NOVA-XO/ABU_Robocon_2026/(list of files, cad)

Other CAD files:
hardware/pcb_3d.obj
