NOVA-XO/ABU_Robocon_2026/Robot1_Code/Core/Src/main.c

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
/* Includes ------------------------------------------------------------------*/
#include "main.h"

/* USER CODE BEGIN Includes */
#include "general.h"
#include "test.h"
#include <stdio.h>
/* USER CODE END Includes */

/* USER CODE BEGIN PD */
/* ---- Robot1 2 PCB сонголт: build хийхээсээ ӨМНӨ 1/2 болгож сольж flash --- */
#define R1_PCB 2 // 1 = 1-р PCB (жолоо/актуатор),  2 = 2-р PCB
/* USER CODE END PD */

ADC_HandleTypeDef hadc1;

I2C_HandleTypeDef hi2c2;

TIM_HandleTypeDef htim1;
TIM_HandleTypeDef htim3;
TIM_HandleTypeDef htim4;
TIM_HandleTypeDef htim7;
TIM_HandleTypeDef htim13;

UART_HandleTypeDef huart4;
UART_HandleTypeDef huart3;
DMA_HandleTypeDef hdma_uart4_tx;

void SystemClock_Config(void);
static void MX_GPIO_Init(void);
static void MX_DMA_Init(void);
static void MX_I2C2_Init(void);
static void MX_TIM1_Init(void);
static void MX_UART4_Init(void);
static void MX_USART3_UART_Init(void);
static void MX_TIM3_Init(void);
static void MX_TIM4_Init(void);
static void MX_TIM7_Init(void);
static void MX_TIM13_Init(void);
static void MX_ADC1_Init(void);
/* USER CODE BEGIN PFP */

int control_data[5][4] = {0};

void send_DMA(uint8_t command) {
  HAL_UART_Transmit(&huart4, &command, 1, HAL_MAX_DELAY);
}
uint8_t information[23]; // шинэ урт
uint8_t rx_idx = 0;
uint8_t data;

/* ---- 2 PCB хоорондын UART4 холбоо: [0x0A][pwm1][pwm2][pwm3][0x0D]
 * ------------ PCB1 → r1_link_send3(p1,p2,p3),  PCB2 ← RX callback
 * (r1_link_p1/2/3). ⚠ PCB1 UART4_TX(PA0) → PCB2 UART4_RX(PA1) + GND утсаар
 * холбоно.               */
volatile uint8_t r1_link_p1 = 100; // PCB2: ирсэн pwm1 (100 = нейтрал/зогсох)
volatile uint8_t r1_link_p2 = 100; // PCB2: ирсэн pwm2
volatile uint8_t r1_link_p3 = 100; // PCB2: ирсэн pwm3
volatile uint8_t r1_link_new = 0;  // 1 = шинэ багц ирлээ (уншаад 0 болгоно)
static uint8_t link_byte = 0;      // UART4 RX буфер (1 байт)
static uint8_t link_state = 0;     // 0=START 1..3=pwm 4=END
static uint8_t link_tmp[3] = {0};  // задарч буй pwm-ууд

/* PCB1 → PCB2: [0x0A][p1][p2][p3][0x0D] (UART4 TX, blocking богино) */
void r1_link_send3(uint8_t p1, uint8_t p2, uint8_t p3) {
  uint8_t pkt[5] = {0x0A, p1, p2, p3, 0x0D};
  HAL_UART_Transmit(&huart4, pkt, 5, 5);
}

/* -----------------------------------------------------------------------------
 *  HAL_UART_RxCpltCallback — ESP32-оос ирсэн PS5 багцыг задлах (huart3, 1
 * байт/удаа)
 *
 *  Багц: 23 байт,  [0]=0xAA (START) ... [22]=0x0A (END),  [21]=холболтын флаг.
 *  START байт хүлээж, 23 байт бүрдэхэд задалж control_data[5][4]-д хийнэ.
 *
 *  ─ Джойстик (information[1..4] − 100 → control_data[0][0..3], утга −100..100)
 * ─ control_data[0][0] = Зүүн стик X       control_data[0][2] = Баруун стик X
 *      control_data[0][1] = Зүүн стик Y       control_data[0][3] = Баруун стик
 * Y
 *
 *  ─ Товч (information[5..20] → control_data[1..4][0..3], утга 0/1) ─
 *      control_data[1][0]=Cross    [1][1]=Square   [1][2]=Triangle
 * [1][3]=Circle control_data[2][0]=D-Down   [2][1]=D-Right  [2][2]=D-Up
 * [2][3]=D-Left control_data[3][0]=L1       [3][1]=R1       [3][2]=L2 [3][3]=R2
 *      control_data[4][0]=Share    [4][1]=Options  [4][2]=L3       [4][3]=R3
 *
 *  Холбогдоогүй (флаг = 0) бол бүх утгыг 0 болгож цэвэрлэнэ.
 * -----------------------------------------------------------------------------
 */
void HAL_UART_RxCpltCallback(UART_HandleTypeDef *huart) {
  if (huart == &huart3) {
    if (rx_idx == 0 && data != 0xAA) {
      HAL_UART_Receive_IT(&huart3, &data, 1);
      return;
    }

    information[rx_idx++] = data;

    if (rx_idx == 23 && information[22] == 0x0A) {
      uint8_t isConnected = information[21];

      if (isConnected == 1) {
        // --- Джойстик: information[1..4] → control_data[0][0..3], төв 100-г
        // хасаж -100..100 ---
        //   [0][0]=LStickX  [0][1]=LStickY  [0][2]=RStickX  [0][3]=RStickY
        for (int i = 0; i < 4; i++) {
          control_data[0][i] = information[1 + i] - 100;
        }

        // --- Товч: information[5..20] → control_data[1..4][0..3] (0/1) ---
        //   мөр 1 = Cross/Square/Triangle/Circle
        //   мөр 2 = D-pad Down/Right/Up/Left
        //   мөр 3 = L1/R1/L2/R2
        //   мөр 4 = Share/Options/L3/R3
        for (int i = 0; i < 16; i++) {
          control_data[1 + (i / 4)][i % 4] = information[5 + i];
        }

      } else {
        // --- Холбогдоогүй: бүх джойстик/товчийг тэглэх ---
        for (int i = 0; i < 5; i++) {
          for (int j = 0; j < 4; j++) {
            control_data[i][j] = 0;
          }
        }
      }

      rx_idx = 0;
    } else if (rx_idx >= 23) {
      rx_idx = 0; // invalid
    }

    HAL_UART_Receive_IT(&huart3, &data, 1);
  } else if (huart == &huart4) {
    /* PCB2: [0x0A][p1][p2][p3][0x0D] багцыг задлана */
    switch (link_state) {
    case 0:
      if (link_byte == 0x0A)
        link_state = 1;
      break; // START
    case 1:
      link_tmp[0] = link_byte;
      link_state = 2;
      break; // pwm1
    case 2:
      link_tmp[1] = link_byte;
      link_state = 3;
      break; // pwm2
    case 3:
      link_tmp[2] = link_byte;
      link_state = 4;
      break; // pwm3
    default: // END
      if (link_byte == 0x0D) {
        r1_link_p1 = link_tmp[0];
        r1_link_p2 = link_tmp[1];
        r1_link_p3 = link_tmp[2];
        r1_link_new = 1;
      }
      link_state = 0;
      break;
    }
    HAL_UART_Receive_IT(&huart4, &link_byte, 1);
  }
}

/* USER CODE END PFP */

/* USER CODE BEGIN 0 */

extern int timer;
extern int counter[4];

uint8_t usb_received_value = 0;
uint8_t usb_new_data_flag = 0;

/* USER CODE END 0 */

/**
 * @brief  The application entry point.
 * @retval int
 */
int main(void) {

  /* MCU Configuration--------------------------------------------------------*/

  /* Reset of all peripherals, Initializes the Flash interface and the Systick.
   */
  HAL_Init();

  /* Configure the system clock */
  SystemClock_Config();

  /* Initialize all configured peripherals */
  MX_GPIO_Init();
  MX_DMA_Init();
  MX_I2C2_Init();
  MX_TIM1_Init();
  MX_UART4_Init();
  MX_USART3_UART_Init();
  MX_TIM3_Init();
  MX_TIM4_Init();
  MX_TIM7_Init();
  MX_TIM13_Init();
  MX_ADC1_Init();
  /* USER CODE BEGIN 2 */
  generalInit();

#if R1_PCB == 2
  /* PCB2: PCB1-ээс UART4 команд хүлээж авахаар RX interrupt-ыг зэвсэглэнэ */
  HAL_UART_Receive_IT(&huart4, &link_byte, 1);
#endif

  /* ГАР УДИРДЛАГАТАЙ РОБОТ (manual)
   *   Autonomous хэсэг (LPMS gyro, sequence, red/blue) хасагдсан.
   *   PS5 джойстикоор differential (tank) жолоодоно; серво/соленоид/brush зэрэг
   *   товчны удирдлагыг while(1) дотор нэмнэ.
   */
  /* USER CODE END 2 */

  /* Infinite loop */
  /* USER CODE BEGIN WHILE */
  while (1) {
    /* R1_PCB (PD хэсэгт) сонголтоор тухайн PCB-ийн удирдлага ажиллана */
#if R1_PCB == 1
    robot1_pcb1(); // 1-р PCB: жолоо + соленоид + мотор 5/6
#else
    robot1_pcb2(); // 2-р PCB
#endif
  }
  /* USER CODE END WHILE */

}

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
