NOVA-XO/ABU_Robocon_2026/Robot2_PCB2_Code/Robot2_PCB2_Code.ioc

Mcu.UserName=STM32F407VETx
PA0-WKUP.GPIO_Label=TX
PA0-WKUP.Signal=UART4_TX
PA1.GPIO_Label=RX
PA1.Signal=UART4_RX
PA10.GPIO_Label=Brush2
PA10.Signal=S_TIM1_CH3
PA11.Signal=USB_OTG_FS_DM
PA12.Signal=USB_OTG_FS_DP
PA13.Signal=SYS_JTMS-SWDIO
PA14.Signal=SYS_JTCK-SWCLK
PA15.GPIO_Label=OP2
PA15.Signal=GPIO_Output
PA2.Signal=USART2_TX
PA3.Signal=USART2_RX
PA4.GPIO_Label=Sen8
PA4.Signal=GPIO_Input
PA6.GPIO_Label=SERVO
PA6.Signal=S_TIM13_CH1
PA8.GPIO_Label=Brush1
PA8.Signal=S_TIM1_CH1
PA9.GPIO_Label=OP4
PA9.Signal=GPIO_Output
PB1.GPIO_Label=M2Pwm
PB1.Signal=S_TIM3_CH4
PB10.GPIO_Label=SCL
PB10.Signal=I2C2_SCL
PB11.GPIO_Label=SDA
PB11.Signal=I2C2_SDA
PB3.GPIO_Label=M5InB
PB3.Signal=GPIO_Output
PB4.GPIO_Label=En1_In
PB4.Signal=GPIO_Input
PB5.GPIO_Label=M6InA
PB5.Signal=GPIO_Output
PB6.GPIO_Label=En2_Ext
PB6.Signal=GPXTI6
PB7.GPIO_Label=M6InB
PB7.Signal=GPIO_Output
PB8.GPIO_Label=En1_Ext
PB8.Signal=GPXTI8
PB9.GPIO_Label=M1Pwm
PB9.Signal=S_TIM4_CH4
PC0.GPIO_Label=Sen6
PC0.Signal=GPIO_Input
PC1.GPIO_Label=M3InB
PC1.Signal=GPIO_Output
PC11.GPIO_Label=OP1
PC11.Signal=GPIO_Output
PC12.GPIO_Label=En4_In
PC12.Signal=GPIO_Input
PC13-ANTI_TAMP.GPIO_Label=M2InB
PC13-ANTI_TAMP.Signal=GPIO_Output
PC14-OSC32_IN.GPIO_Label=Sen5
PC14-OSC32_IN.Signal=GPIO_Input
PC15-OSC32_OUT.GPIO_Label=M3InA
PC15-OSC32_OUT.Signal=GPIO_Output
PC2.GPIO_Label=Sen7
PC2.Signal=GPIO_Input
PC3.GPIO_Label=photoRes
PC3.Signal=SharedAnalog_PC3
PC6.GPIO_Label=M6Pwm
PC6.Signal=S_TIM3_CH1
PC7.GPIO_Label=M5Pwm
PC7.Signal=S_TIM3_CH2
PC8.GPIO_Label=OP6
PC8.Signal=GPIO_Output
PC9.GPIO_Label=OP5
PC9.Signal=GPIO_Output
PD1.GPIO_Label=En3_In
PD1.Signal=GPIO_Input
PD10.GPIO_Label=OP3
PD10.Signal=GPIO_Output
PD11.GPIO_Label=BnoReset
PD11.Signal=GPIO_Output
PD12.GPIO_Label=M3Pwm
PD12.Signal=S_TIM4_CH1
PD13.GPIO_Label=OP8
PD13.Signal=GPIO_Output
PD14.GPIO_Label=M4Pwm
PD14.Signal=S_TIM4_CH3
PD15.GPIO_Label=OP7
PD15.Signal=GPIO_Output
PD2.GPIO_Label=M4InA
PD2.Signal=GPIO_Output
PD3.GPIO_Label=En2_In
PD3.Signal=GPIO_Input
PD4.GPIO_Label=M4InB
PD4.Signal=GPIO_Output
PD5.GPIO_Label=En4_Ext
PD5.Signal=GPXTI5
PD6.GPIO_Label=M5InA
PD6.Signal=GPIO_Output
PD7.GPIO_Label=En3_Ext
PD7.Signal=GPXTI7
PD8.Signal=USART3_TX
PD9.Signal=USART3_RX
PE0.GPIO_Label=Sen1
PE0.Signal=GPIO_Input
PE1.GPIO_Label=M1InA
PE1.Signal=GPIO_Output
PE11.Signal=S_TIM1_CH2
PE14.Signal=S_TIM1_CH4
PE2.GPIO_Label=Sen2
PE2.Signal=GPIO_Input
PE3.GPIO_Label=M1InB
PE3.Signal=GPIO_Output
PE4.GPIO_Label=Sen3
PE4.Signal=GPIO_Input
PE5.GPIO_Label=M2InA
PE5.Signal=GPIO_Output
PE6.GPIO_Label=Sen4
PE6.Signal=GPIO_Input
PE8.GPIO_Label=Buzzer
PE8.Signal=GPIO_Output
PH0-OSC_IN.Signal=RCC_OSC_IN
PH1-OSC_OUT.Signal=RCC_OSC_OUT
