NOVA-XO/ABU_Robocon_2026/Robot2_Code/Core/Inc/red.h

/* =============================================================================
 *  red.h — Улаан (red) талын автомат зэвсгийн дараалал (weapon_red)
 *
 *  weapon_blue-ийн ТОЛИН ТУСГАЛ (align БАРУУН тийш, эцсийн эргэлт −180°).
 *
 *  Төсөл : STM32F407 Robot Firmware
 *  Огноо : Aug 22, 2026
 *  Автор : nova
 * =============================================================================
 */

#ifndef INC_RED_H_
#define INC_RED_H_

#include "general.h" // main.h, ssd1306.h, default.h, lpms.h-г дамжуулж авчирна

uint8_t weapon_red(void);       // улаан талбарын дараалал — дуусвал 1
void    weapon_red_reset(void); // эхнээс нь дахин ажиллуулах

#endif /* INC_RED_H_ */
