NOVA-XO/ABU_Robocon_2026/Robot2_PCB2_Code/Core/Inc/tactic.h

/* =============================================================================
 *  tactic.h — "Scroll & Zone Tracker" тактикийн сүлжээ (ABU Robocon 2026)
 *
 *  3 багана x 4 мөр сүлжээ. Бокс бүр  "---" → "FAK" → "R1S" → "R2S"  циклээр
 *  солигдоно. Курсор ба сонголтыг PS5 джойстикоор (PCB1-ээс USART2-оор ирнэ)
 *  удирдана. Төлөв өөрчлөгдөх бүрд төв систем рүү UART4-өөр GRID мөр илгээнэ.
 *
 *  Хамаарал: ssd1306 (OLED, hi2c2), default.c/send_uart (huart4), control_data.
 *
 *  Төсөл : STM32F407 Robot2 PCB2 Firmware
 *  Автор : nova
 * =============================================================================
 */

#ifndef INC_TACTIC_H_
#define INC_TACTIC_H_

#include "main.h"

/* -----------------------------------------------------------------------------
 *  Tactic_Task — тактикийн сүлжээний НЭГ давталт (non-blocking).
 *
 *  selectMode()-оос  while(true){ Tactic_Task(); }  хэлбэрээр дуудна. Дотроо
 *  ямар ч блоклодог HAL_Delay ашиглахгүй — бүх цаг хугацаа HAL_GetTick дээр.
 *  Эхний дуудалтад өөрийгөө init хийж, анхны (бүх хоосон) төлвийг илгээнэ.
 * -----------------------------------------------------------------------------
 */
void Tactic_Task(void);

#endif /* INC_TACTIC_H_ */
