NOVA-XO/ABU_Robocon_2026/(commit log)

2026-07-04 Initial commit: ABU Robocon 2026 STM32 robot firmware
    - Mecanum drive, rack PID (encoder, TIM7 ISR-held)
    - LPMS-BE2 gyro turning/straight, anchor heading
    - Non-blocking sequence blocks (up_20/down_20/up_40/down_40), red/blue sides
    - PS5 controller via ESP32 UART bridge
    - SSD1306 OLED, PCA9685, solenoids, servos
2026-07-08 WIP: rack удирдлагын шинэчлэл + limit switch homing (тохиргоо дуусаагүй)
    Rack унах / савлах асуудлыг шийдэх зорилгоор удирдлагын гогцоог дахин зохиов:
    - rack_step: тасралтгүй PID + таталцлын feedforward + шүүсэн (low-pass)
    derivative damping + integral gravity compensation. Роботын жин
    нэмэгдэхэд барих хүчээ автоматаар тохируулна.
    - Rack_SetHome: доод limit switch хүртэл буулгаж encoder-ийг тэглэнэ
    (debounce, timeout; switch олдоогүй бол тэглэлгүй аюулгүй зогс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
2026-07-08 chore: төслийн нэрийг Robot2_Code болгов
    - .project : <name>Code</name> → Robot2_Code
    - CMakeLists.txt : CMAKE_PROJECT_NAME → Robot2_Code
    - Code.ioc → Robot2_Code.ioc (ProjectName / ProjectFileName шинэчлэв)
    - Code Debug.launch → Robot2_Code Debug.launch
    (elf нэр, PROJECT_ATTR, MAPPED_RESOURCE_PATHS шинэчлэв)
    - .cproject : хуучнаас үлдсэн "kle_code" нэрийг Robot2_Code болгов
    (buildPath ба project name хоёуланг)
    - .launch дотор өөр компьютерийн зам (Chinbayar\workspace_2.1.1) үлдсэнийг зассан
    ТЭМДЭГЛЭЛ: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
2026-07-08 refactor: repo-г monorepo болгож өөрчлөв (Robot1_Code + Robot2_Code)
    Хоёр роботын төслийг нэг репод дэд фолдер болгон нэгтгэв:
    - Robot2_Code — автомат робот (сүүлийн код, өмнөх root агуулга)
    - Robot1_Code — гар удирдлагатай робот (general.c/.h, main.c-г
    Robot2-ийн сүүлийн хувилбартай тэнцүүлж ижил суурьнаас эхлүүлэв)
    - Дээд түвшний .gitignore нэмэв (.metadata/ үл хэрэгсэнэ)
2026-07-08 refactor(Robot1): гар роботоос autonomous модулиудыг хасав
    Гар удирдлагатай роботод шаардлагагүй хэсгүүдийг устгав:
    - Устгасан файл: lpms, bno055, sequence, red, blue (.c/.h)
    - general.h/.c: gyro функц (Drive_Straight, Gyro_TurnAngle) болон
    lpms.h include-ийг хасав. mecanum (runner) + rack PID үлдээв.
    - main.c: autonomous include болон оношилгооны блокийг цэвэрлэж,
    while(1)-д runner() (гар mecanum жолоо) тавьв.
    - CMakeLists.txt: target_sources-оос устгасан файлуудыг хасав.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
2026-07-08 chore: multi-root workspace нэмэв (Robot1 + Robot2 зэрэг нээх)
2026-07-08 docs: root README, hardware/ фолдер, нийтлэг ESP32 гүүр; Robot1 README
    - Root README.md — monorepo тойм (2 робот, нэг ижил PCB, ESP32 гүүр)
    - ps5_esp32_bridge.ino-г хоёр фолдероос гаргаж, root-ийн нийтлэг
    ps5_esp32_bridge/ фолдер руу зөөв (давхардал арилгав)
    - Robot1_Code/README.md — гар роботод тохируулж дахин бичив
    - Robot2_Code/README.md — автомат робот гэдгийг тэмдэглэж, ESP32 холбоос засав
    - hardware/ фолдер — PCB (EasyEDA) зураг/файл нэмэх заавартай
    - .code-workspace — clangd тох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
2026-07-08 chore: root main.c давхардлыг устгав (build-д ороогүй хуучин хуулбар)
    Жинхэнэ entry point нь Core/Src/main.c (cmake-ийн MX_Application_Src-д
    зөвхөн тэр орсон). Robot1_Code/main.c ба Robot2_Code/main.c нь хуучин
    хуулбарууд байсан.
2026-07-08 docs(hardware): PCB схемийн функциональ блокуудыг баримтжуулав
2026-07-08 feat(hardware): PCB 3D загвар нэмэв (Git LFS, 21MB)
    pcb_3d.obj (Git LFS) + pcb_3d.mtl. mtllib заагчийг цэвэр нэр рүү зассан.
    .gitattributes-д hardware/*.obj-г LFS-ээр tracking хийв.
    [pcb_3d.obj]
2026-07-08 docs(hardware): PCB layout + 6 schematic зураг нэмэв
    hardware/pcb.png (root README-д харагдана) + Sheet1..6 схемүүд;
    hardware/README.md дотор бүгдийг embed хийв.
2026-07-08 fix(Robot2): general.c-д <stdlib.h> нэмэв (abs() build алдаа)
    GCC 14 дээр -Wimplicit-function-declaration нь warning биш АЛДАА тул
    runner() доторх abs() build-ыг зогсоож байв.
    [general.c]
2026-07-08 refactor(Robot1): differential робот болгов, rack устгав, жолоо тааруулав
    Robot1 бол mecanum БИШ, энгийн differential (tank) гар робот тул:
    - runner(): mecanum inverse kinematics -> differential mixing (strafe хассан).
    V (урагш) ба W (эргэлт)-д ТУСДАА gain: SPEED_GAIN=10 (стик 100 -> 1000 PWM),
    TURN_GAIN=8 (стик 100 -> 800 PWM). Нормчлолыг PWM орон зайд ±1000 руу
    шилжүүлсэн тул явж байхад эргэлтийн хүч хадгалагдана (өмнө нь 800-д таслагдаж
    байлаа).
    - Rack-ийн БҮХ кодыг устгав (энэ роб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
2026-07-08 docs: README-г differential болгож шинэчлэв (Robot1 mecanum/rack хассан)
    - Robot1 README: mecanum -> differential (tank); rack хэсэг устгав;
    SPEED_GAIN/TURN_GAIN тэмдэглэв; актуатор үйлдлүүд хэрэгжээгүйг #2-т холбов.
    - Root README: Robot1-ийг "differential (tank) жолоодлого" болгов.
    Ref #2
2026-07-14 feat(Robot1): гар роботын актуатор удирдлага (соленоид toggle)
    Гарын гогцоонд механизмын удирдлага нэмэв (өмнө нь зөвхөн жолоодлого):
    - solenoidControl(): L1/R1/L2/R2 -> соленоид 1/5/2/4. Товч дарах бүрд
    HIGH <-> LOW сэлгэнэ (toggle). Дараад барихад давтахгүй — debounce хийсэн
    ЦЭВЭР rising-edge (btn_rising). Холболтыг SOLENOID_MAP хүснэгтээр удирдана.
    - Square -> соленоид 6 (момент), D-Up/D-Down -> мотор 6, Triangle/Cross -> мотор 5.
    - Build эвдрэл засав: main.c-д сан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
2026-07-14 feat(Robot2): rack тохируулга баталгаажуулав, PID тааруулав, preset + серво нэмэв
    RACK ТОХИРУУЛГА (тоног төхөөрөмж дээр ХЭМЖИЖ тогтоов):
    - Rack_Joystick_Test-ийг АВТОМАТ илрүүлэгч болгов: мотор<->encoder хос,
    PWM<->encoder чиглэлийн нийцэл, мотор<->limit switch харьяаллыг өөрөө хэмжинэ.
    - Хэмжилт: FRONT = M6 / counter[1] / S2 , BACK = M5 / counter[0] / S1.
    Чиглэл: +PWM -> counter ӨСНӨ (хоёуланд нь).
    - ЗАСВАР: rack_at_home() нь switch-ийг enc индексээр сонгодог байсан т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
2026-07-17 refactor(Robot1): USB CDC устгав, ADC хөлийг OP3 болгов
    CubeMX-ээс USB_DEVICE/CDC-г бүрэн хасав (USB_DEVICE/, Middlewares дахь
    USB Device Library, HAL PCD/LL_USB драйверууд). Robot1-д USB ашиглагдахгүй
    байсан тул зөвхөн build-ийг хүндрүүлж байв.
    Мөн:
    - photoRes_Pin (PC3) → OP3: ADC оролтоос соленоид 3-ын гаралт болгов.
    generalInit нь MX_ADC1_Init-ийн ДАРАА ажилладаг тул PC3-ыг
    GPIO_MODE_OUTPUT_PP болгож analog горимыг дарж бичнэ.
    - SOLENOID_MAP: R1-ийн соленоидыг 5 → 3 болгов.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
2026-07-17 feat(Robot2): 90° gyro эргэлт, Drive_Straight, weapon_blue, горим сонголт
    Gyro эргэлт (general.c):
    - Gyro_TurnAngle-ийг ажиллах болгов: init доторх HAL_Delay(25мс) хасав
    (LPMS-ийн урсгалыг иддэг), KD/KI идэвхжүүлэв (өмнө нь цэвэр P), шүүсэн
    derivative нэмэв (LPMS 90Hz vs PID 10ms → түүхий derivative чимээтэй).
    - Тааруулга хэмжилтээр: 14° алдаа дээр ~110 PWM өгч 76°-д ГАЦАЖ байсан тул
    KP 5→12, MIN_PWM 50→200 (дугуй газар зурах статик үрэлт). TOL 3→1.5
    (3.0 үед 87°-д зогсдог б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
2026-07-17 feat(Robot2_PCB2): 2 дахь PCB-ийн төсөл үүсгэв (Robot2_Code-оос цэвэр суурь)
    Robot2 нь хоёр PCB-тэй. Энэ бол 2 дахь самбарын firmware — Robot2_Code-оос
    хуулж, тухайн самбарт байхгүй тоног төхөөрөмжийн кодыг хасав.
    Төслийн нэр солив: .project, .cproject, CMakeLists.txt, .ioc (файл + доторх
    ProjectName/ProjectFileName), Debug.launch — бүгд Robot2_PCB2_Code.
    ХАССАН (энэ самбарт байхгүй тоног төхөөрөмж):
    - lpms.c/h — LPMS-BE2 gyro (UART4 одоо чөлөөтэй)
    - blue.c/h, red.c/h, sequence.c/h — а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
2026-07-17 chore: Robot2_PCB2_Code-ыг VS Code workspace-д нэмэв
    Multi-root workspace нь фолдеруудыг ТОДОРХОЙ жагсаадаг — диск дээр шинэ
    төсөл үүсгэхэд VS Code түүнийг автоматаар авахгүй. Robot2_Code-ийн нэрийг
    "Robot2 (auto)" → "Robot2 (auto, PCB1)" болгож 2 самбарыг ялгав.
2026-07-18 feat(Robot2): weapon_blue бүтэн дараалал, climb 1/2/3, нэг PS5-аар 2 PCB
    Robot2_Code (PCB1):
    - weapon_blue: S0 урагш(val5) → S1 рак 1900 → S3 урагш+серво буулгах(val8) →
    S4 val3 align (зүүн, gyro+val8 шахалт) → S4B 1сек хүлээх → соленоид1+серво180
    → S5 500мс ухрах+рак 1950 → S6 180° эргэх. Бүх төлөвт Rack_Fault шалгана.
    - Ракийн буулт: хурдны governor (closed-loop) — хоёулаа хамт буухад бодит
    хурдыг encoder-ээр хэмжиж VMAX-д барина (open-loop PWM таглахаас найдвартай).
    - RACK_TIMEOUT_M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
2026-07-25 feat(Robot2): шоо-авах граб (front-down-20 f/b), moon PI, 2-PCB уялдаа, mode цэгцлэлт
    - grab_front_down_20_f/_b бүтэн дараалал (sun±90, sol, moon, strafe→PCB1)
    - moon_hold-д integral нэмж steady-state алдаа арилгав (ачаан дор зорилтод хүрэх)
    - 14 grab combination stub; auto_climb-д front-down-20_f холбов
    - Inter-PCB strafe протокол (0xB7: зогс/зүүн/баруун), PCB1 grab_step дагана
    - auto_climb гарах маневр: зүүн90°→val5 MAX→баруун90°→рак700→val5→рак0
    - Rack: home=switch, pwm_soft, RACK_HOME_APPROACH floor (PCB1)
    - Mode: мод1=auto_climb/tact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
2026-07-25 chore: debug launch.json цэгцлэв (3 робот, богино нэр, давхардал арилгав)
    - Robot1_Code: "Debug Robot1" config нэмэв (өмнө хоосон байсан)
    - Robot2_Code (PCB1) ба Robot2_PCB2_Code (PCB2): тус бүр НЭГ config
    - PCB2-оос давхардсан PCB1-ийг устгав; нэрсийг богиносгов (Debug Robot1/PCB1/PCB2)
2026-08-19 feat: Robot1 2-PCB линк ба R2 давхарга; Robot2 climb-grab уялдаа, tictactoe, weapon
    Robot1 (PCB1/PCB2, R1_PCB):
    - 2 PCB линк (UART4): p1→M2, p2→M3, p3→M1; PCB2 хүлээж авч эргүүлнэ
    - R2 shift давхарга: Triangle/Cross→M5(сул)/M3(дарсан), D-Up/Dn→M6(сул)/M1(дарсан)
    - M3 Cross дээр sol1 OFF үед val1==0 болтол зогсох логик
    - Соленоид: D-Left→sol6 (2сек pulse), D-Right→sol5 (momentary), sol7 байнга ON
    Robot2 PCB1 (Robot2_Code):
    - auto_climb: next-block grab (M дээрээс M+3), up байрлалт, дараагийн MOVE алгасалт
    - Drive_Distance (encoder+gyro+ду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
2026-08-19 docs: README-уудыг одоогийн 2-PCB / climb / grab / tactic байдалд шинэчлэв
    - root: робот бүр 2 PCB болохыг тусгаж, Robot2_PCB2_Code нэмэв; PCB-хоорондын
    линкийн протокол (Robot1 UART4, Robot2 USART2)
    - Robot1: R1_PCB 2-PCB тайлбар, удирдлагын хүснэгт (R2 давхарга, соленоид);
    хуучирсан "актуатор бичигдээгүй" төлвийг арилгав
    - Robot2_Code: PCB1 (их бие) гэдгийг тодотгож, climb/tictactoe/weapon +
    PCB2-той линкийн протокол нэмэв
    - Robot2_PCB2_Code: PCB1-ийн буруу хуулбарыг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
2026-08-22 feat(Robot2): weapon_red (blue-ийн толин тусгал), серво home 0, ADC check mode
    - weapon_red нэмэв (red.c/red.h): weapon_blue-ийн ТОЛИН ТУСГАЛ — align нь
    val3-аар БАРУУН тийш (blue нь зүүн), эцсийн эргэлт −180° (blue нь +180°).
    Хуучин ашиглагдаагүй Red_Run/Red_Reset-ийг сольсон.
    - default.c: mode 3 = "RUN red" (өмнөх test_sensor-ыг сольсон),
    шинэ mode 27 = "ADC check" (PC3 = ADC1_IN13 raw утгыг OLED-д).
    - Серво home = 0: SERVO_HOME_DEG = SERVO_DEG_MIN (өмнө 180°); хуучин
    "180°" комментуудыг тодруулав (Servo_Home hardw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
2026-08-22 fix(Robot2): серво эргүүлж суурилуулсныг servo_deg_to_units-д global flip
    - servo_deg_to_units: deg = SERVO_DEG_MAX - deg (нэг цэгээр flip). Auto
    дараалал (weapon_blue/red) БА гарын △ preset хоёул үүгээр дамждаг тул
    нэг мөрөөр зөв болно. g_servo_deg (logical) хэвээр — зөвхөн hardware
    өнцөг эргэнэ.
    - red.c: WR_SERVO_DOWN/UP-ыг blue-тэй ижил (0/180) болгож буцаав — flip
    төвлөрсөн тул тал бүрд тусад нь солих шаардлагагүй.
    [general.c, red.c]
